MCodez/Sorting-Machine-Intel-8085-Microprocessor-Project/S_M_Schematic_PDF.pdf

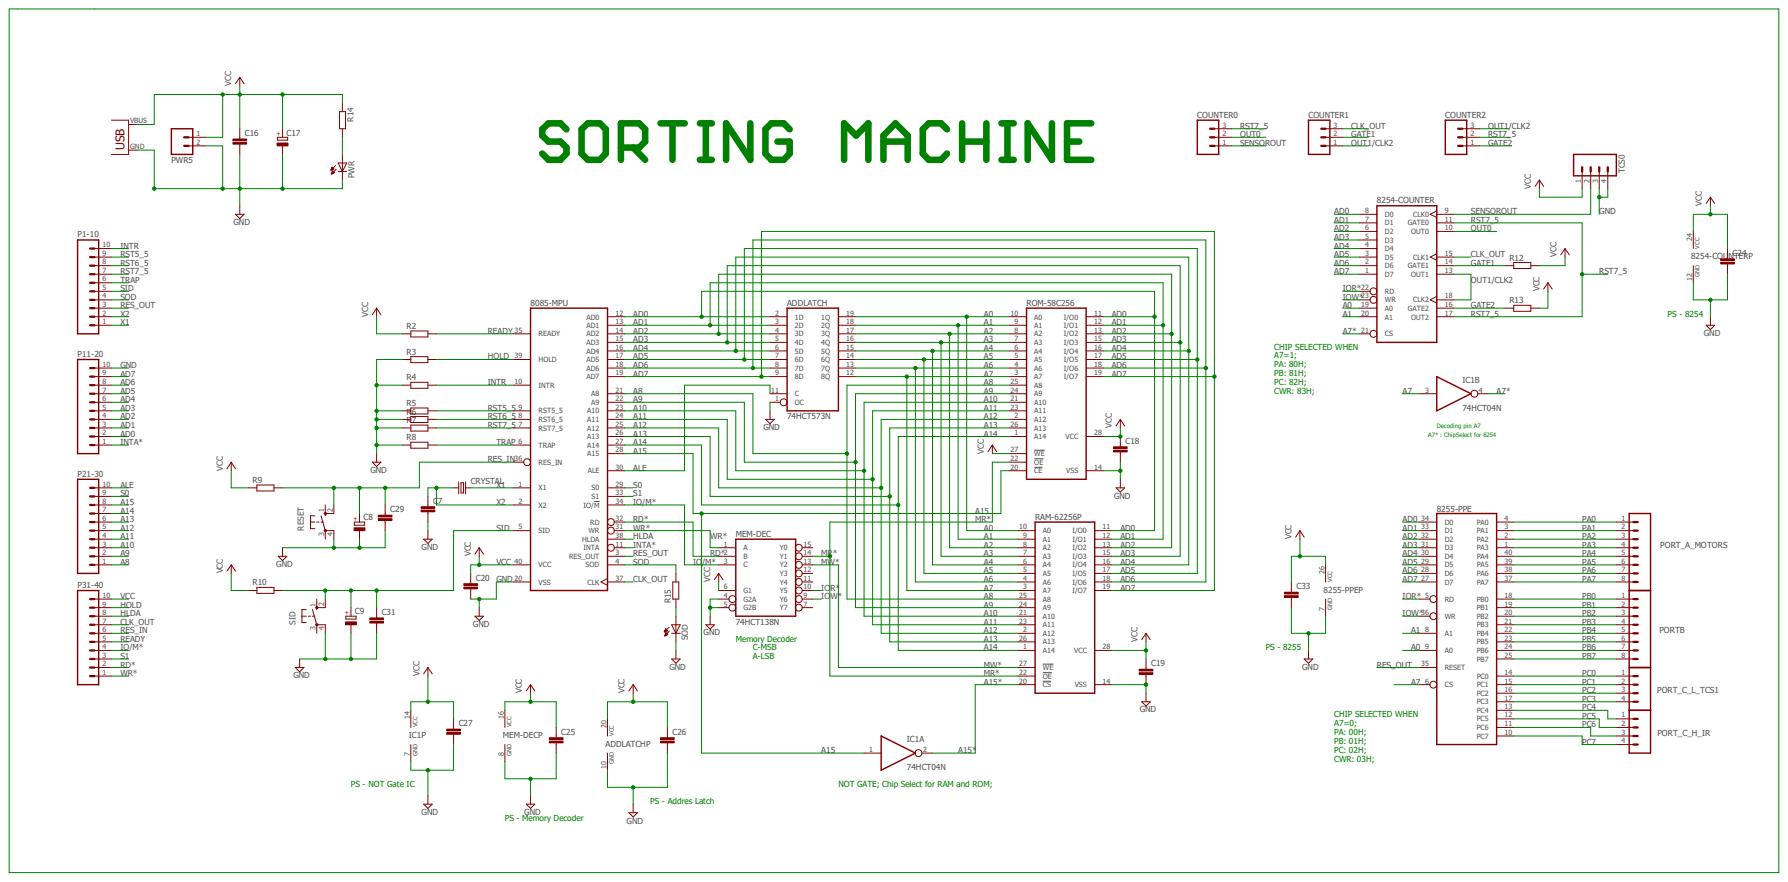
[picture p18: page 1]

MEM-DECP 8 16 GND VCC

PS - NOT Gate IC

NOT GATE; Chip Select for RAM and ROM;
