MCodez/Sorting-Machine-Intel-8085-Microprocessor-Project/(commit log)

2017-05-20 MCodez
    Schematic and Board files for my project.
    [S_M_v4.1_Board.sch, S_M_v4.1_Schematic.sch]
2017-05-20 MCodez
    Datasheets of relevant Hardware used. Arduino file for Stepper motor PORT MANIPULATION added.
